odtu/PowerLabKiCadLibraries/(commit log)

2025-05-09 10uF 100V 1210 Cer Cap & 20pF 50V 0603 Cer Cap
2025-05-09 100uF 63V Alum Pol Cap 8.00*13.50mm
2025-05-10 SMBJ48CA-13-F DO-214AA TVS Diode
2025-05-13 How to import library updates to KiCad?
2025-05-15 100 uH 6*6mm Inductor
2025-05-15 Shunt Resistor 2 mOhm 2512
2025-05-15 147 kOhm 0603 1/10 Watt Chip Resistor
2025-05-15 100 uH 6*6mm SMD Inductor
2025-05-16 Schottky Diode SOD-323 NSR0320MW2T1G
2025-05-16 2 N-Chn MOSFET NVMFD6H840NLWFT1G
2025-05-17 USB TYPE-C Connector - USB4105
2025-05-19 0603 22 Ohm- 1 kOhm - 1.8 kOhm
2025-05-19 0603 1uF 10V - 1210 100uF 10V
2025-05-20 Library Arrangements & New Signal & Power Connectors
2025-05-21 Molex 0430451209 Signal Connectors
2025-05-23 120 Ohm - 4.7 kOhm 0603 Resistors
2025-05-23 CANBus 8-SOIC
2025-05-23 CANBus Interface
2025-05-26 Molex Signal Connectors
2025-06-12 Chip Resistors | 6.34 kOhm & 232kOhm 0603 1/10W
2025-06-13 Chip Resistors - 93.1 kOhm 0603 1/10W
2025-06-16 Some Chip Resistors Added
2025-06-22 [Signal Connectors] Samtec Inc FTSH-120-04-F-DH-A
    2x40 SMD R/A 1.27mm Pitch Male Header
2025-06-23 [Signal Connectors] Samtec Inc FTSH-120-04-F-DH-A
    Footprint Match
2025-06-25 [TVS Diodes] Bourns Inc. CDSOD323-T24SC
    SOD-323, 26.7V Breakdown Voltage
2025-06-25 [Chip Resistors] Stackpole Electronics Inc RMCF0603FT1K50
    1.5 kOhm, ±1%, 1/10W, 0603 (1608 Metric)
2025-06-25 [SMD Ceramic Cap] Samsung Electro-Mechanics CL10B221JB8NNNC
    220 pF, 50V, ±5%, 0603 (1608 Metric)
2025-06-26 [MOSFETs] Alpha & Omega Semiconductor Inc. AO3400A
    N-Ch 30V 5.7A SOT-23-3
2025-06-26 [Ideal Diodes] Texas Instruments LM5050Q1MK-1/NOPB
2025-06-27 [Encoders] Monolithic Power Systems Inc. MA730GQ-Z
2025-06-27 [C2000 C28x] Texas Instruments F280049CSZ
    Pin Name
2025-06-28 [MOSFETs] Properties Arrangements
2025-07-08 [Chip Resistors] 9.1 kOhm & 86.7 kOhm
2025-07-14 [Power Connectors] Molex - 2125201002
2025-07-22 [Signal Connectors] Molex - 2147210040 - 1*4 Signal Connectors
2025-07-24 0603 LEDs
2025-07-28 [Ceramic Cap] CGA6P1X7R1N106K250AC | TDK Corp.
    10uF 75V 1210 %10
2025-07-30 [Shunt Resistors] YAGEO - PA0805FRE870R002L
    2mOhm - 1W - %1 - 0805
2025-07-30 [Screw Terminals] 7700
2025-07-31 [GaN Power Stages] EPC - 23102
    80V 35A Half Bridge
2025-08-02 [Cer Cap] Murata Electronics - GRM21BD72A225ME01K
    2.2uF - 100V - 0805
2025-08-02 [Chip Resistors] 0603 Res
    RMCF0603FT118K - RMCF0603FT22K1
2025-08-03 [Current Sense Amp] TI - INA240A4DR
2025-09-01 [Tactile Switches] E-Switch - TL6330AF200Q
2025-09-01 [Encoders] RLS - RLC2HD
2025-09-08 [Cer Cap] TDK - C2012X5R2A475K125AC
    4.7uF 100V 0805
2025-09-13 New Ceramic Capacitors
    1uF 100V 0603 & 10uF 100V 1206
2025-09-14 [Power Connectors] XT30(2+2)PW-M
2025-10-06 [MOSFETs] onsemi - NTMFS006N08MC
    80V - 82A- N-ch
2026-04-27 New MOSFET NVMFS6H800NT1G
    onsemi NVMFS6H800NT1G 80V 203A
2026-05-18 TVS Diode SP0115-01UTG
    Littelfuse Inc. 0603 1.4Brkdwn 8.9Clmp
2026-06-06 SMAJ54CA TVS Diode
2026-07-07 RLM Encoder
2026-07-07 Header Connectors
2026-08-27 [Reg] Buck Converter LMR38020FSDDAR TI
2026-09-08 Chip Resistors
    Stackpole 110 kOhm 0603
    Stackpole 64.9 kOhm 0603
2026-09-13 Texas Instruments TL494CDR
    PWM Controllers
2026-09-20 Standardize symbol/footprint fields and geometry, fix broken links
    - Symbols: unify custom field names (whitespace/typos/duplicates),
    fix reference designators (IC/U6 -> U), fill in missing Datasheet
    links, fix wrong file casing (METUPowerLaB/METUPowerlab -> METUPowerLab),
    remove a leftover MIC28514T-E/PHA symbol with a broken footprint link
    to a nonexistent external library.
    - Footprints: rename files to drop spaces/stray trailing spaces, fix
    attr smd/through_hole mismatches, add missing solder_mask_margin,
    normalize silkscreen line width and Reference/Value text size, add
    missing descr fields, fix 3D model paths to use METUPOWERLAB_3D
    consistently, delete an unidentified or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
2026-09-22 Add design rule for thermal/high-current big pads
    Document the B.Cu mirror pad + same-numbered thermal via array
    convention for shield/ground/VIN/drain-source pads, matching the
    pattern already used in 13-PowerWFQFN.kicad_mod.
2026-09-25 Release 2.0.0: KiCad 10, remove C2000 library, library fixes
    Breaking:
    - Requires KiCad 10 (some libraries are in the KiCad 10 file format).
    The KiCad 9 package is kept as PowerLabKiCadLibrariesKiCAD9.zip (1.0.0).
    - Remove the C2000 C28x microcontroller library (symbols, footprints,
    3D models).
    - Buck regulator pin types: GND power_in, EN/FB/RT-SYNC input,
    PG open_collector.
    Fixes:
    - Buck converters: correct TPS561201DDCR Mouser number, add missing
    descriptions, clean datasheet links; TPS561201DDCR moves to a new
    TSOT-23-6 footprint.
    - TL494CDR: add manufacturer, specs and distributor fields.
    - SMAJ54CA moves to a new DO-214AC (SMA) footprint; fix TVS package fields.
    - 8-PowerTDFN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
2026-09-27 Restrict courtyard and keepout areas to RF/magnetic-sensitive parts
    Normal components no longer get a courtyard or keepout zone; only parts
    with a datasheet-defined RF/magnetic sensitive area (ESP32 antenna,
    magnetic encoders such as RLC2HD) may use them. Remove the copper
    keepout zones from the SMD inductor and Micro-Fit connector footprints.
2026-09-27 Add ESP32-WROOM-32E microcontroller symbol and footprint
    Adds a new METUPowerLab_Microcontrollers_ESP32 library with the
    ESP32-WROOM-32E SMD module (symbol + castellated-pad footprint),
    following the conventions in HowToCreateNewDesign/DesignRules.md.
    - 38-pin symbol, pinout from Espressif ESP32-WROOM-32E/-32UE
    datasheet v2.1 (Table 3), grouped functionally (power/EN/ADC-input
    pins on the left, GPIO + NC cluster on the right).
    - Footprint: 18.0 x 25.5mm body, 38 SMD rect pads on 1.27mm pitch
    matching the datasheet's recommended PCB land pattern (Figure 13),
    plus the antenna keepout zone + F.CrtYd courtyard over the RF area
    (the documented courtyard/keepout exception for ESP32 modu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
2026-09-27 Add power symbols, mounting holes, fiducial, test pads, net tie; fix ESP32, MOSFET, eFuse, TMP235
    New libraries:
    - METUPowerLab_Schematic_PowerSymbols: GND, +V_RAIL (value = rail name), PWR_FLAG
    - METUPowerLab_Mechanicals_MountingHoles: M2.5/M3, NPTH and plated
    - METUPowerLab_Mechanicals_Fiducials: 1 mm dot, 2 mm mask opening, 3 mm copper keepout
    - METUPowerLab_TestPoints_SurfaceMounts: bare-pad test points (D1.0/D1.5) + symbol
    - METUPowerLab_NetTies_SurfaceMounts: 2-pin 0.5 mm net tie + symbol (Kelvin sense)
    New parts: INA240A1DR, SMBJ36CA-13-F, LM74700QDBVRQ1 (+ TI DBV land pattern
    footprint SOT-23-6_DBV), 3.65 kOhm and 1.33 kOhm RMCF0603.
    - ESP32-WROOM-32E footprint was mirrored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
2026-09-27 NetTie_2_0.5mm symbol: pins on the 2.54 mm grid; LM74700QDBVRQ1: wider body
2026-09-28 Fix exposed-pad padstacks and mask margins; add graphics library and ESP32 3D model
    Found while laying out a 4-layer 3-phase ESC with these parts (kicad-cli DRC):
    - 48-VQFN (DRV8323) and 23-LQFN-CLIP (TPS16890): pad solder-mask margin 0.1 -> 0.05 mm.
    On the 0.5 mm pitch the 0.1 mm margin leaves a 0.06 mm mask web, below the 0.1 mm fab
    minimum, so neighbouring pins shared one mask opening (solder_mask_bridge errors).
    - 8-SOICPower (LMR38020): exposed pad had paste/mask on both sides but copper only on
    F.Cu (padstack warning, stray bottom mask opening) -> F.Cu/F.Paste/F.Mask. Thermal vias
    0.5 mm pad on 0.3 mm drill (0.1 mm annular ring, below PCBWay's 0.13 mm) -> 0.6 mm;
    paste remov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
2026-10-02 Add Infineon 1EDN8511BXUSA1 low-side gate driver library
    - New METUPowerLab_GateDrivers_LowSide library: 1EDN8511BXUSA1
    single-channel 4A/8A low-side gate driver (EiceDRIVER), SOT-23-6.
    - Symbol: IN+/IN- inputs, separate OUT_SRC/OUT_SNK outputs, VDD/GND;
    datasheet, specs and Digi-Key/Mouser/Farnell numbers.
    - Footprint: Infineon PG-SOT23-6-2 recommended land pattern
    (0.5x0.8 mm pads, 0.95 mm pitch, 2.4 mm row spacing).
    - 3D model: generic SOT-23-6 body under GateDrivers/LowSide.
    - Regenerate PowerLabKiCadLibraries.zip from the current tree and
    update metadata.json sha256/sizes.
2026-10-06 Add automatic library standards checks for pull requests
    - tools/check_library.py: stdlib-only checker (own S-expression parser)
    that maps HowToCreateNewDesign/DesignRules.md to ERROR/WARNING rules
    for symbol libraries and footprints; supports paths, --all and
    --changed BASE_REF, prints GitHub annotations under Actions.
    - .github/workflows/library-checks.yml: standards check on changed files,
    KiCad 10 load test (kicad-cli SVG export in kicad/kicad:10.0), and a
    guard against PRs modifying the PCM zip / metadata.json.
    - PR template checklist and README section on running the checks locally.
2026-10-06 Merge library pull requests automatically when all checks pass
    New workflow auto-merge.yml runs after "Library checks" completes
    (workflow_run, from main, never runs PR code) and merges the PR as
    github-actions[bot] when:
    - every check passed on the PR's current head commit,
    - the author has write access to the repository,
    - only symbols/, footprints/ or 3dmodels/ change,
    - it isn't a draft and has no hold / do-not-merge / release label.
    A PR whose files are already identical on main is closed as a duplicate.
    workflow_dispatch with dry_run=true reports the decision for any PR.
    HowToCreateNewDesign/README.md documents it and the hold label.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
2026-10-07 Add METUPowerLab_Connectors_Headers, METUPowerLab_Interfaces_USBBridges, powerlab.3dshapes
2026-10-09 Add inductive encoder parts: LDC5072, MSPM0G3507, TLV9062, REF35330, TPS709, 2x6 header, passives
    - METUPowerLab_Microcontrollers_MSPM0: MSPM0G3507SRHBR (VQFN-32_RHB, EP + thermal vias)
    - METUPowerLab_Amplifiers_OpAmps: TLV9062IDGKR (VSSOP-8_DGK)
    - METUPowerLab_References_VoltageReferences: REF35330QDBVR (SOT-23-6_DBV)
    Added to existing libraries:
    - Sensors_Encoders: LDC5072EPWRQ1 (TSSOP-16_PW)
    - Regulators_LDOs: TPS70933DBVR, TPS70950DBVR (SOT-23-5_DBV)
    - Connectors_Headers: 2x6 (Wurth 61301221121, THT, odd/even numbering)
    - Capacitors_Ceramics_SurfaceMounts: 100 pF, 390 pF (GCM C0G 50V), 470 nF (X7R 25V)
    - Resistors_ChipResistors: 4.7 Ohm, 100 kOhm 0.1%
    Land patterns from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
2026-10-09 Add 2x6 Female socket (Wurth 61301221821) to Connectors_Headers
    WR-PHD 2.54 mm dual socket header, straight, 12 pins (insulator 8.5 mm,
    tails 3.1 mm, recommended hole 1.02 mm). Board-to-board mate for the
    "2x6" male header 61301221121.
    Pad 1 is at the footprint origin like 61301221121, odd pins in the x=0
    column, but the even column is at x=-2.54 (KiCad PinSocket convention),
    so this socket on the top of one board mates pin-for-pin with the
    61301221121 header flipped onto the bottom of the other board when both
    footprints share the same X/Y anchor.
    3D model is KiCad stock PinSocket_2x06_P2.54mm_Vertical.step, renamed,
    with NOTICE.md attribution (CC-BY-SA 4.0).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
2026-10-09 Release 2.1.0: rebuild PowerLabKiCadLibraries.zip and metadata.json
    The package was last built before PRs #8-#12. 2.1.0 adds those libraries
    (GateDrivers_LowSide additions, Logics_Counters/Timers, Connectors_Headers,
    Interfaces_USBBridges) and the inductive encoder parts of this PR.
    Zip built from the tracked tree as before (metadata.json inside with
    install_size); root metadata.json has the new sha256 and sizes.
    (cherry picked from commit 27f7e15f94c002e2216b29de4c7b7e773578e46c)
2026-10-11 Add between-pads keepout to inductor footprints and design rule
    All 13 footprints in METUPowerLab_Inductors_SurfaceMounts get an F.Cu
    keepout zone ("Inductor Keepout") covering the gap between the two pads:
    tracks, vias and copper pour not allowed, pads and footprints allowed.
    DesignRules.md: inductors become a second exception to the no-keepout
    rule; inductors with >= 0.6 mm between pads (room for one 0.2 mm track
    at 0.2 mm clearance) must carry this keepout.
    check_library.py: new fp-inductor-keepout warning for inductor
    footprints missing the keepout or with wrong settings; the inductor
    keepout no longer triggers fp-courtyard-keepout.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
2026-10-11 Release 2.2.0: rebuild PowerLabKiCadLibraries.zip and metadata.json
    Adds the between-pads keepout on all inductor footprints and the
    footprint changes from PR #15 (0603_Medium ceramic cap/LED/resistor,
    ESP32-WROOM-32E, TL6330AF200Q, SOT-23), which were not in 2.1.0.
    Zip built from the tracked tree as before (minus .github/, tools/ and
    the zips; metadata.json inside with install_size); root metadata.json
    has the new version, sha256 and sizes.
2026-10-12 Use IEC (European) rectangle body for chip resistor symbols
    Replace the ANSI zigzag with an IEC 60617 rectangle (5.08 x 2.032 mm,
    background fill) on all 45 symbols in METUPowerLab_Resistors_ChipResistors.
    Pins, field positions and symbol extent are unchanged.
2026-10-12 Remove METUPowerLab_Schematic_PowerSymbols
    Power symbols are net markers, not parts: schematics use KiCad's built-in
    `power` library (Place > Power Symbols) instead. Existing schematics keep
    their embedded copies; Change Symbols to power:GND / power:+3V3 / power:+5V /
    power:PWR_FLAG (keeping the Value) clears the missing-library warning.
2026-10-13 Show key ratings on passive, discrete and power symbols
    Make the one to three ratings you would otherwise open the datasheet for
    visible on the schematic, at 1.0 mm text stacked under the Value:
    resistor power/tolerance, capacitor voltage, MOSFET VDS/ID/RDSon,
    inductor current/saturation current, ferrite bead impedance/current,
    diode and TVS voltages, PTC hold/trip current, LED forward voltage,
    crystal load capacitance, regulator output/input voltage and current,
    power connector current.
    Field names are shown only where the value alone could be misread.
    Shunt resistors get a Power field (from their Description). Fixes along
    the way: inductor "1AA", TVS "5(Max)", "2.1mOhm", "1/10 Watt"; EPC2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
2026-10-16 Add METUPowerLab_Interfaces_CANBusBridges, METUPowerLab_Transistors_MOSFETs, powerlab.3dshapes
2026-10-17 Split TMS320F280049PMS into functional units; rule for multi-unit symbols
    Power, clock/reset/debug, ADC/DAC/references, PGA/comparator inputs and two
    GPIO banks, instead of one 64-pin block.
2026-10-24 Add small through-hole test points: D1.5/0.8 mm and D2.0/1.0 mm
    The only test point was a 3.0 mm pad with a 1.3 mm drill, too big for
    dense boards. Pad_D1.5mm_Drill0.8mm takes a probe tip or a hook;
    Pad_D2.0mm_Drill1.0mm a hook or a wire. Same form as the 3.0 mm one:
    through_hole, excluded from BOM and position files, solder mask
    margin 0.1, a silk circle and the reference below it, no courtyard.
2026-10-24 Release 2.3.0: rebuild PowerLabKiCadLibraries.zip and metadata.json
    Brings everything merged since 2.2.0 to the Plugin and Content Manager:
    IEC resistor bodies (#17), power symbols library removed in favour of
    KiCad's power:* (#18), key ratings shown on passive and power symbols,
    new CAN bus bridges, MOSFETs, encoder, ceramic capacitor, ferrite bead
    and ideal diode parts (#20, #22, #23), TMS320F280049 split into
    functional units (#21), and the D1.5 / D2.0 mm test points (#24).
    Zip built from the committed files at this commit (git's own line
    endings, one timestamp), minus .github/, tools/ and the zips, with
    directory entries and metadata.json first (install_size only); root
    metadata.json ha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
2026-10-25 Refresh README and retake install screenshots in KiCad 10
    - Rewrite README: badges, highlights, clearer install/update steps,
    path variable table, library catalog, contributing and license.
    - Retake all screenshots in KiCad 10 (were KiCad 9 / version 1.0.0),
    cropped and annotated with numbered markers; English file dialog.
    - Drop the externally hosted Turkish-named screenshot.
2026-10-28 Add PCB-motor driver parts: LMG2100R044, F280039CSPM, INA241A2-Q1, TCAN1044AV-Q1, LMR51430Y, A1220, OS-CON 25SVPF47M, 10 µF 25V 1206
    - LMG2100R044RARR GaN half bridge with a 17-VQFN-FCRLF footprint from TI's RAR0017B land pattern
    (PGND pads mirrored on B.Cu with thermal vias) and a plain CadQuery body
    - F280039CSPM as a 5-unit symbol (power, clock/reset/JTAG, analog, GPIO0-11, other GPIOs) for the
    64-pin PM S-grade map (pin 46 GPIO39); every pin carries its mux functions from SPRSP61C Table 5-1
    as KiCad pin alternates
    - INA241A2QDGKRQ1 (uses METUPowerLab_Amplifiers_OpAmps:VSSOP-8_DGK), TCAN1044AVDRQ1 (8-SOIC),
    LMR51430YDDCR (TSOT-23-6)
    - New libraries: METUPowerLab_Sensors_HallEffec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
2026-10-28 Add METUPowerLab_Microcontrollers_STM32 with STM32G491MET3 (80-LQFP)
    - STM32G491MET3 (Cortex-M4F 170 MHz, 512 KB flash, USB FS, FDCAN, -40 to 125 C) as a 6-unit symbol:
    power, clock/reset/boot/SWD, then ports A, B, C and D+E
    - Pin names and every pin's alternate functions come from ST's STM32_open_pin_data
    (STM32G491M(C-E)Tx.xml); alternate pin types follow KiCad's generated STM32G4 symbol
    - LQFP-80 12x12 mm 0.5 mm footprint in lab style (rect pads, 0.1 mm mask margin, no courtyard),
    pad positions and sizes as KiCad's IPC-7351 LQFP-80_12x12mm_P0.5mm; KiCad's 3D model with a NOTICE file
2026-10-28 Add STM32F103CBT7 (LQFP-48) and FL0800011Q 8 MHz crystal
    - STM32F103CBT7 (Cortex-M3 72 MHz, 128 KB flash, USB FS, -40 to 105 C) in
    METUPowerLab_Microcontrollers_STM32 as a 5-unit symbol: power, clock/reset/boot/SWD,
    ports A, B and C; every pin's alternate functions from ST's STM32_open_pin_data
    (STM32F103C(8-B)Tx.xml), alternate types as KiCad's STM32F1 symbol
    - LQFP-48 7x7 mm 0.5 mm footprint in lab style (pads as KiCad's IPC-7351 nominal footprint),
    KiCad's 3D model with a NOTICE file
    - Diodes FL0800011Q 8 MHz 12 pF crystal (-40 to 125 C) on the existing 4-SMD_3.2x2.5mm footprint
    Used as an on-board DAPLink (CMSIS-DAP) debugger, the pin-out of DAPLink's stm32f103xb interface.
    Co-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
2026-10-28 DesignRules: multiplexed pins carry every function as KiCad pin alternates
    New rule under the multi-unit section: MCU, DSP and other multiplexed pins list all their
    other functions as KiCad pin alternates, taken from the vendor's machine-readable pin data
    (ST's STM32_open_pin_data, TI's Pin Attributes table), so a schematic can show the function
    each pin is used for.
2026-10-28 Fix TPS2492PWR pin types: GND power input, NC no-connect
    GND (pin 7) and NC (pin 10) were power outputs, so ERC reported a
    power-output conflict with any PWR_FLAG on GND.
2026-10-28 Add 2.5 mOhm TLR3A20KR0025FTDG shunt with a 2512 Kelvin footprint
    TE TLR3A20KR0025FTDG, 2.5 mOhm 1 % 2 W 2512 metal foil, +-150 ppm/C.
    The symbol has four pins: 1/2 carry the current, 3/4 are the sense taps.
    2512_Kelvin follows TE's TLR3A 4-wire land pattern (2.7 x 1.45 mm pads,
    1.0 mm apart, 2.95 mm across). The existing 2512 footprint's 3.8 mm pad
    gap is wider than this part's 3.75 mm terminal gap, so it is not reused.
2026-10-29 Add DRV5055A2EDBZRQ1 linear Hall sensor with a TI DBZ SOT-23 footprint
2026-10-30 Fix IAUZ30N06S5L140: split source pins, redraw PG-TSDSON-8-32 footprint
    The symbol's source pin was numbered "1,_2,_3", so footprint pads 1-3
    got no net. It is now pin 1 plus hidden stacked pins 2 and 3.
    8-PowerTDFN is redrawn from Infineon's PG-TSDSON-8-32 land pattern
    (IAUZ30N06S5L140 datasheet rev 1.2, p. 8): origin at the package
    centre, 0.34 x 1.15 mm pins, slotted drain pad with its stencil
    apertures, drain copper mirrored on B.Cu, and 2 thermal vias at 1.0 mm
    pitch instead of 9 at 0.5 mm (which failed hole-to-hole clearance).
2026-11-02 Add METUPowerLab_Inductors_SurfaceMounts, METUPowerLab_Switching_PWMControllers, powerlab.3dshapes
2026-11-03 Add METUPowerLab_Jumpers_SolderJumpers with a 3-pad bridged solder jumper
    SolderJumper_3_Bridged12 and its footprint SolderJumper-3_P1.3mm_Bridged12_Pad1.0x1.5mm:
    three 1.0 x 1.5 mm rect pads at 1.3 mm pitch, pads 1-2 joined by a 0.6 mm copper strip
    (net_tie_pad_groups "1, 2"), one mask opening over all three. Cut the strip and bridge
    2-3 with solder to change over. Not in the BOM or the position file.
    The checker and DesignRules.md now allow the JP prefix on solder jumpers, as NT is
    allowed on net ties.
2026-11-04 Add weekly whole-library audit and pin/pad checks
    check_library.py gets new rules, run on PRs and in the weekly audit:
    - sym-pin-pad (error): a symbol pin number with no pad in the linked footprint
    - sym-pad-unused (warning): a footprint copper pad with no symbol pin
    - sym-pin-number (error) / sym-pin-duplicate (warning): missing or reused pin numbers
    - fp-pad-size (error): zero-size pads, drill not smaller than the pad
    - fp-pad-overlap (error): pads with different numbers overlapping
    - fp-pad-clearance (warning): pads closer than 0.15 mm
    - fp-annular-ring (warning): plated hole ring under 0.1 mm
    plus --markdown FILE to write the full report.
    weekly-library-audit.yml runs every Monday 06:00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
2026-11-04 Fix all weekly-audit findings: NC pins, keywords, vias, models
    Symbols
    - TMP235A4DCKR: add NC pins 1 and 5 (SC70 pinout, TI SBOS857E)
    - CSD88599Q5DC: add NC pins 5, 7, 8, 9, 10 (TI pins 21 and 23-26)
    - ki_keywords filled for 63 symbols and lowercased for 50
    - SN74LVC1G08DCKR: Reference and Value visible
    Footprints
    - thermal vias -> thru_hole circle 0.5/0.3, *.Cu *.Mask (7 footprints)
    - solder_mask_margin 0.1 on exposed pads of 24-QFN, 20-VQFN_RGY, 2157601002
    - Reference text thickness 0.1 on 8-SOIC / 8-SOICPower
    - 22-PowerTFDFN tabs rect; RLC2HD courtyard width 0.05
    - 3D models: KiCad stock models copied into powerlab.3dshapes for DO-214AC,
    TSOT-23-6, 8-PowerTDFN; new models for TVS 0603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
2026-11-05 Add NetTie_2_3.0mm, a 3.0 mm wide net tie for high-current joins
    NetTie_2_0.5mm joins its pads with a 0.3 mm bridge (about 1.4 A on 2 oz copper). NetTie_2_3.0mm keeps the 1.0 mm pad pitch but is 3.0 mm wide: pads 0.5 x 3.0 mm, 1.0 x 3.0 mm bridge, about 9 A rms on 2 oz outer copper at a 10 C rise (IPC-2221). First use: the PCB motor driver's phase outputs (8.7 A rms, 15.4 A peak).
