odtu/PowerLabKiCadLibraries/(notices)

Notices in the files:
README.md:
License: CERN-OHL-S-2.0
